pondahai/VFD_IV_18/README.md

# VFD_IV_18

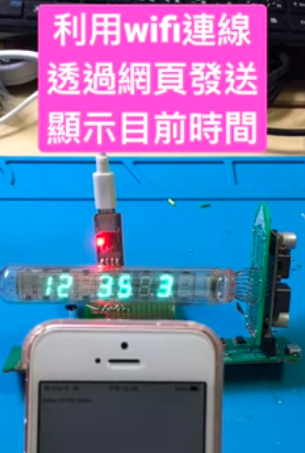
[picture p1: 截圖 2022-12-05 下午3.30.26.png]

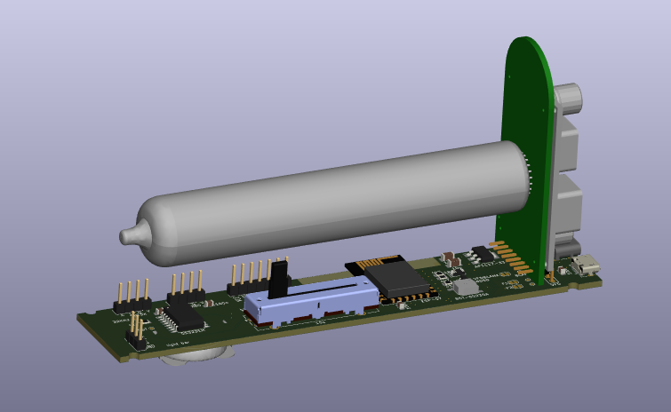
[picture p2: 截圖 2022-07-25 上午10.29.32.png]
