pondahai/VFD_IV_18/hardware/display/v1/IV-18/IV-18.stl

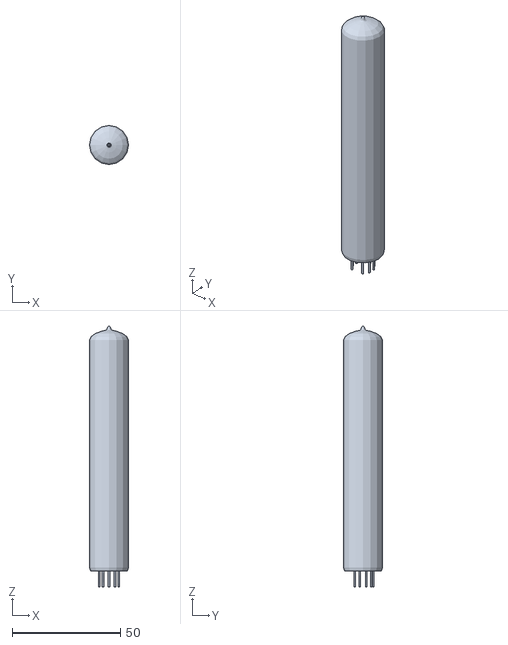
[picture p3: CAD file, 2022-07-25]
hardware/display/v1/IV-18/IV-18.stl
18.0 x 18.0 x 120.4
