pondahai/VFD_IV_18/hardware/main_board/v1/HRO  TYPE-C-31-M-12.step

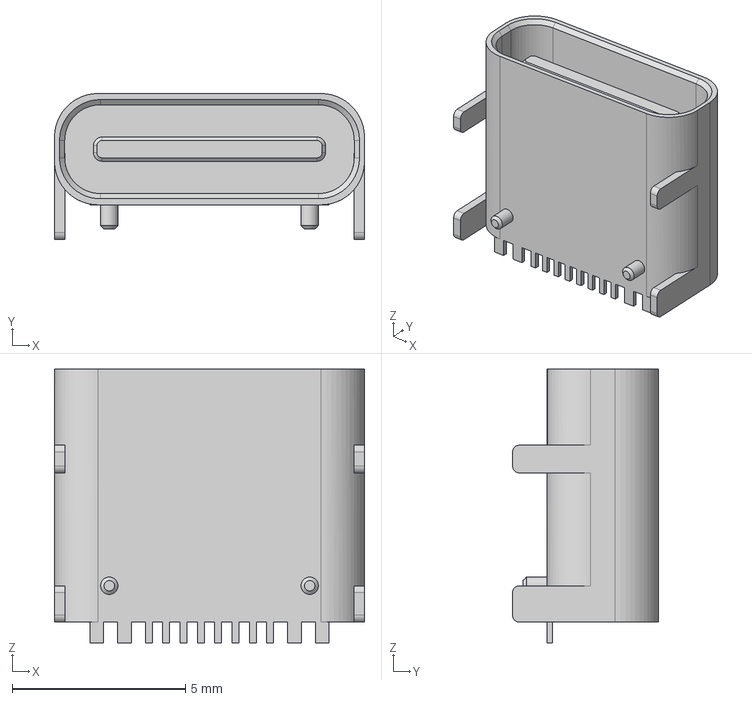
[picture p4: CAD file, 2022-12-05]
hardware/main_board/v1/HRO TYPE-C-31-M-12.step
8.94 x 4.21 x 7.90 mm
