pondahai/VFD_IV_18/hardware/main_board/v1/Battery Holder TH CR2032.stp

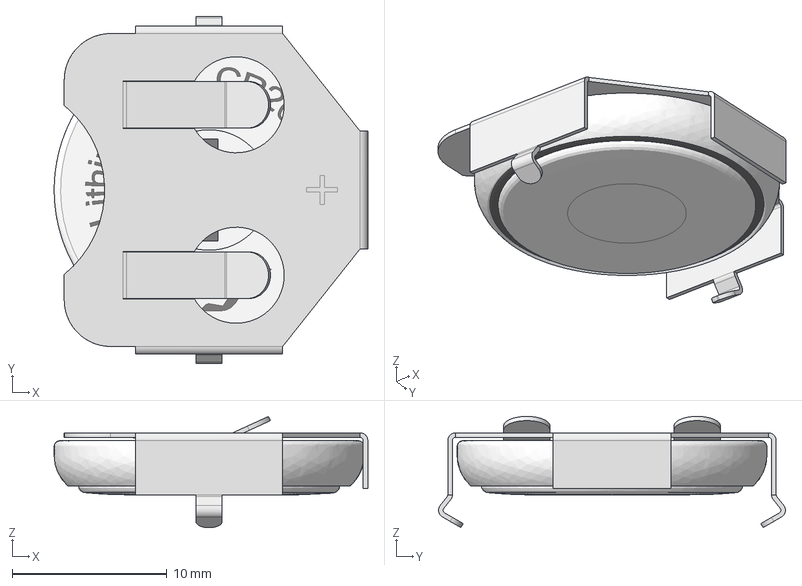
[picture p5: CAD file, 2022-12-05]
hardware/main_board/v1/Battery Holder TH CR2032.stp
20.2 x 22.4 x 7.18 mm
