pondahai/VFD_IV_18/hardware/main_board/v1/BST-5523SA.step

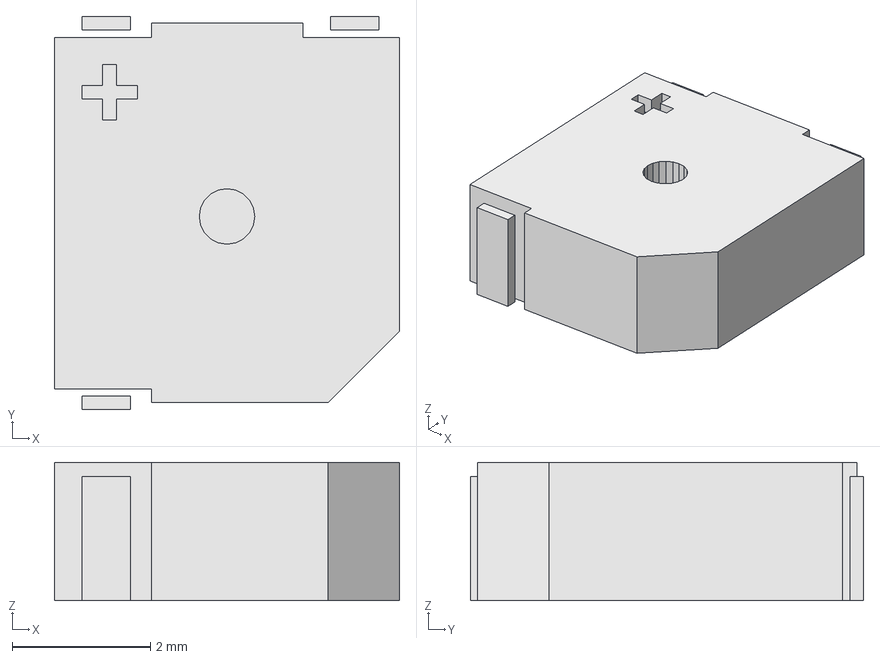
[picture p6: CAD file, 2022-07-25]
hardware/main_board/v1/BST-5523SA.step
5.00 x 5.70 x 2.00 mm
