pondahai/VFD_IV_18/hardware/main_board/v1/PTA2043-2010CIB103--3DModel-STEP-269445.step

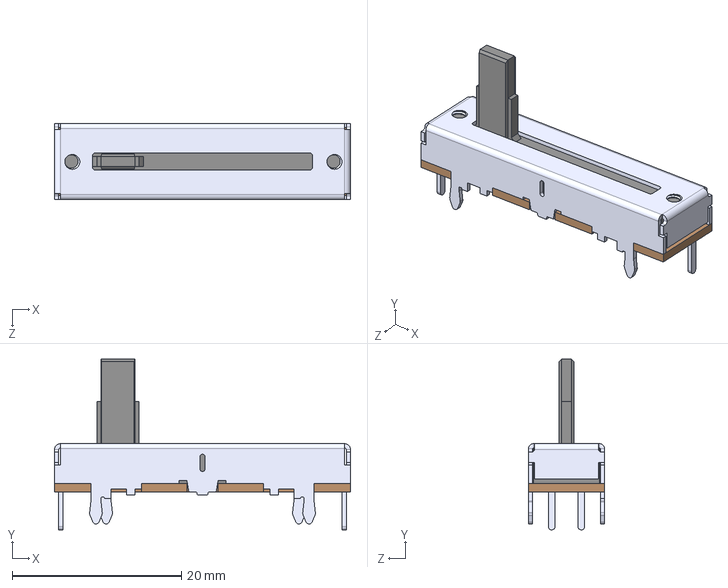
[picture p7: CAD file, 2022-07-25]
hardware/main_board/v1/PTA2043-2010CIB103--3DModel-STEP-269445.step
35.0 x 20.2 x 9.00 mm
