pondahai/VFD_IV_18/(list of files, cad)

Other CAD files:
hardware/main_board/v1/BST-5523SA.stl
