pondahai/VFD_IV_18/hardware/main_board/v1/main.kicad_pcb

## KiCad design hardware/main_board/v1/main.kicad_pcb (2022-12-05)

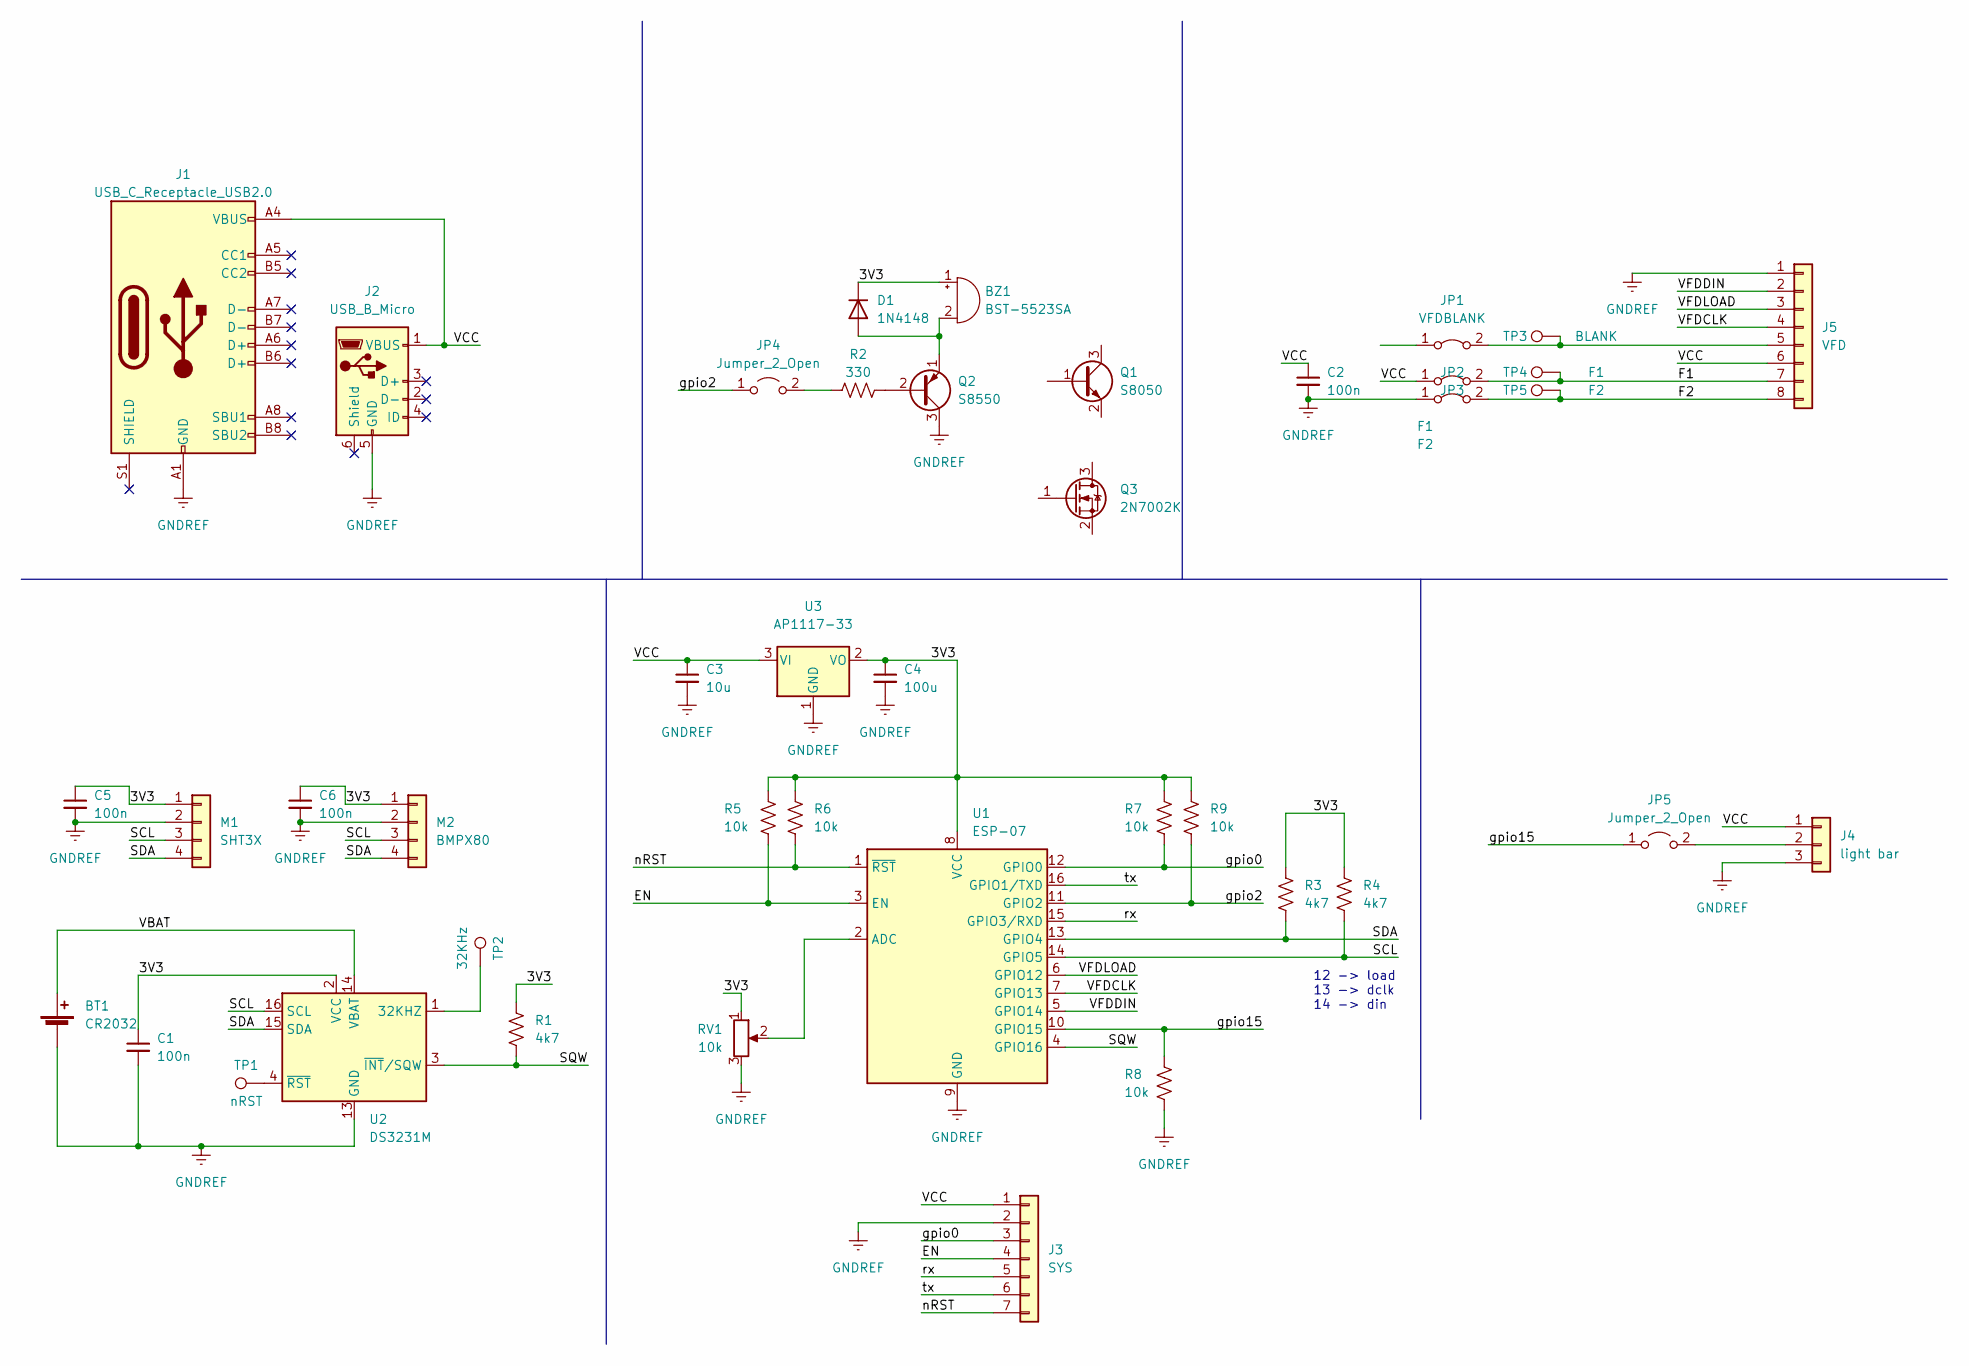
[picture p8: schematic main.kicad_sch]

Parts:
BT1: CR2032; BatteryHolder_Keystone_3002_1x2032
BZ1: BST-5523SA
C1, C2, C5, C6: 100n; C_0805_2012Metric_Pad1.18x1.45mm_HandSolder
C3: 10u; C_1206_3216Metric_Pad1.33x1.80mm_HandSolder
C4: 100u; C_1206_3216Metric_Pad1.33x1.80mm_HandSolder
D1: 1N4148; D_1206_3216Metric_Pad1.42x1.75mm_HandSolder
J1: USB_C_Receptacle_USB2.0; USB_C_Receptacle_Palconn_UTC16-G
J2: USB_B_Micro; USB_Micro-B_GCT_USB3076-30-A
J3: SYS; PinHeader_1x07_P2.54mm_Vertical
J4: light bar; PinHeader_1x03_P2.54mm_Vertical
J5: VFD; PinHeader_1x08_P2.54mm_Vertical
JP1: VFDBLANK; SolderJumper-2_P1.3mm_Bridged_RoundedPad1.0x1.5mm
JP2: F1; SolderJumper-2_P1.3mm_Bridged_RoundedPad1.0x1.5mm
JP3: F2; SolderJumper-2_P1.3mm_Bridged_RoundedPad1.0x1.5mm
JP4, JP5: Jumper_2_Open; SolderJumper-2_P1.3mm_Bridged_RoundedPad1.0x1.5mm
M1: SHT3X; PinHeader_1x04_P2.54mm_Vertical
M2: BMPX80; PinHeader_1x04_P2.54mm_Vertical
Q1: S8050; SOT-23
Q2: S8550; TO-92_Inline
Q3: 2N7002K; SOT-23
R1, R3, R4: 4k7; R_0805_2012Metric_Pad1.20x1.40mm_HandSolder
R2: 330; R_0805_2012Metric_Pad1.20x1.40mm_HandSolder
R5, R6, R7, R8, R9: 10k; R_0805_2012Metric_Pad1.20x1.40mm_HandSolder
RV1: 10k; Potentiometer_Bourns_PTA2043_Single_Slide
TP1: nRST; TestPoint_Pad_D1.0mm
TP2: 32KHz; TestPoint_Pad_D1.0mm
TP3: BLANK; TestPoint_Pad_D1.0mm
TP4: F1; TestPoint_Pad_D1.0mm
TP5: F2; TestPoint_Pad_D1.0mm
U1: ESP-07
U2: DS3231M; SOIC-16W_7.5x10.3mm_P1.27mm
U3: AP1117-33; SOT-223-3_TabPin2

Connections:
/3V3: BZ1.1 (-), C1.1, C4.1, C5.1, C6.1, D1.1 (K), M1.1, M2.1, R1.1, R3.1, R4.1, R5.1, R6.1, R7.1, R9.1, RV1.1, U1.8 (VCC), U2.2 (VCC), U3.2 (VO)
/EN: J3.4, R5.2, U1.3 (EN)
/F1: J5.7, JP2.2 (B), TP4.1
/F2: J5.8, JP3.2 (B), TP5.1
/SCL: M1.3, M2.3, R4.2, U1.14 (GPIO5), U2.16 (SCL)
/SDA: M1.4, M2.4, R3.2, U1.13 (GPIO4), U2.15 (SDA)
/SQW: R1.2, U1.4 (GPIO16), U2.3 (~INT/SQW)
/VBAT: BT1.1 (+), U2.14 (VBAT)
/VCC: C2.1, C3.1, J1.A4 (VBUS), J1.A9 (VBUS), J1.B4 (VBUS), J1.B9 (VBUS), J2.1 (VBUS), J3.1, J4.1, J5.6, JP2.1 (A), U3.3 (VI)
/VFDCLK: J5.4, U1.7 (GPIO13)
/VFDDIN: J5.2, U1.5 (GPIO14)
/VFDLOAD: J5.3, U1.6 (GPIO12)
/gpio0: J3.3, R7.2, U1.12 (GPIO0)
/gpio2: JP4.1 (A), R9.2, U1.11 (GPIO2)
/gpio15: JP5.1 (A), R8.1, U1.10 (GPIO15)
/nRST: J3.7, R6.2, U1.1 (~RST)
/rx: J3.5, U1.15 (GPIO3/RXD)
/tx: J3.6, U1.16 (GPIO1/TXD)
GNDREF: BT1.2 (-), C1.2, C2.2, C3.2, C4.2, C5.2, C6.2, J1.A1 (GND), J1.A12 (GND), J1.B1 (GND), J1.B12 (GND), J2.5 (GND), J3.2, J4.3, J5.1, JP3.1 (A), M1.2, M2.2, Q2.3 (C), R8.2, RV1.3, U1.9 (GND), U2.5 (GND), U2.6 (GND), U2.7 (GND), U2.8 (GND), U2.9 (GND), U2.10 (GND), U2.11 (GND), U2.12 (GND), U2.13 (GND), U3.1 (GND)
unnamed: BZ1.2 (+), BZ1.3, D1.2 (A), Q2.1 (E)
unnamed: J4.2, JP5.2 (B)
unnamed: J5.5, JP1.2 (B), TP3.1
unnamed: JP4.2 (B), R2.1
unnamed: Q2.2 (B), R2.2
unnamed: RV1.2, U1.2 (ADC)
unnamed: TP1.1, U2.4 (~RST)
unnamed: TP2.1, U2.1 (32KHZ)

Notes on the sheet:
12 -> load 13 -> dclk 14 -> din

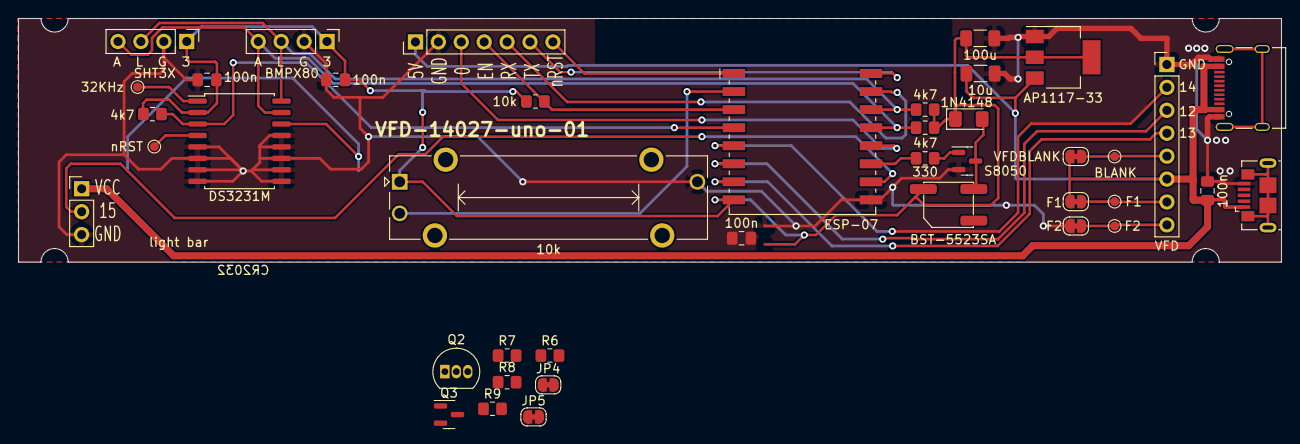
[picture p9: board main.kicad_pcb from above]

Board: 2 copper layers, 140.0 x 27.0 mm, 42 parts (1 on the bottom side), 27 nets.
