pondahai/VFD_IV_18/hardware/display/v1/VFD.kicad_pcb

## KiCad design hardware/display/v1/VFD.kicad_pcb (2022-07-25)

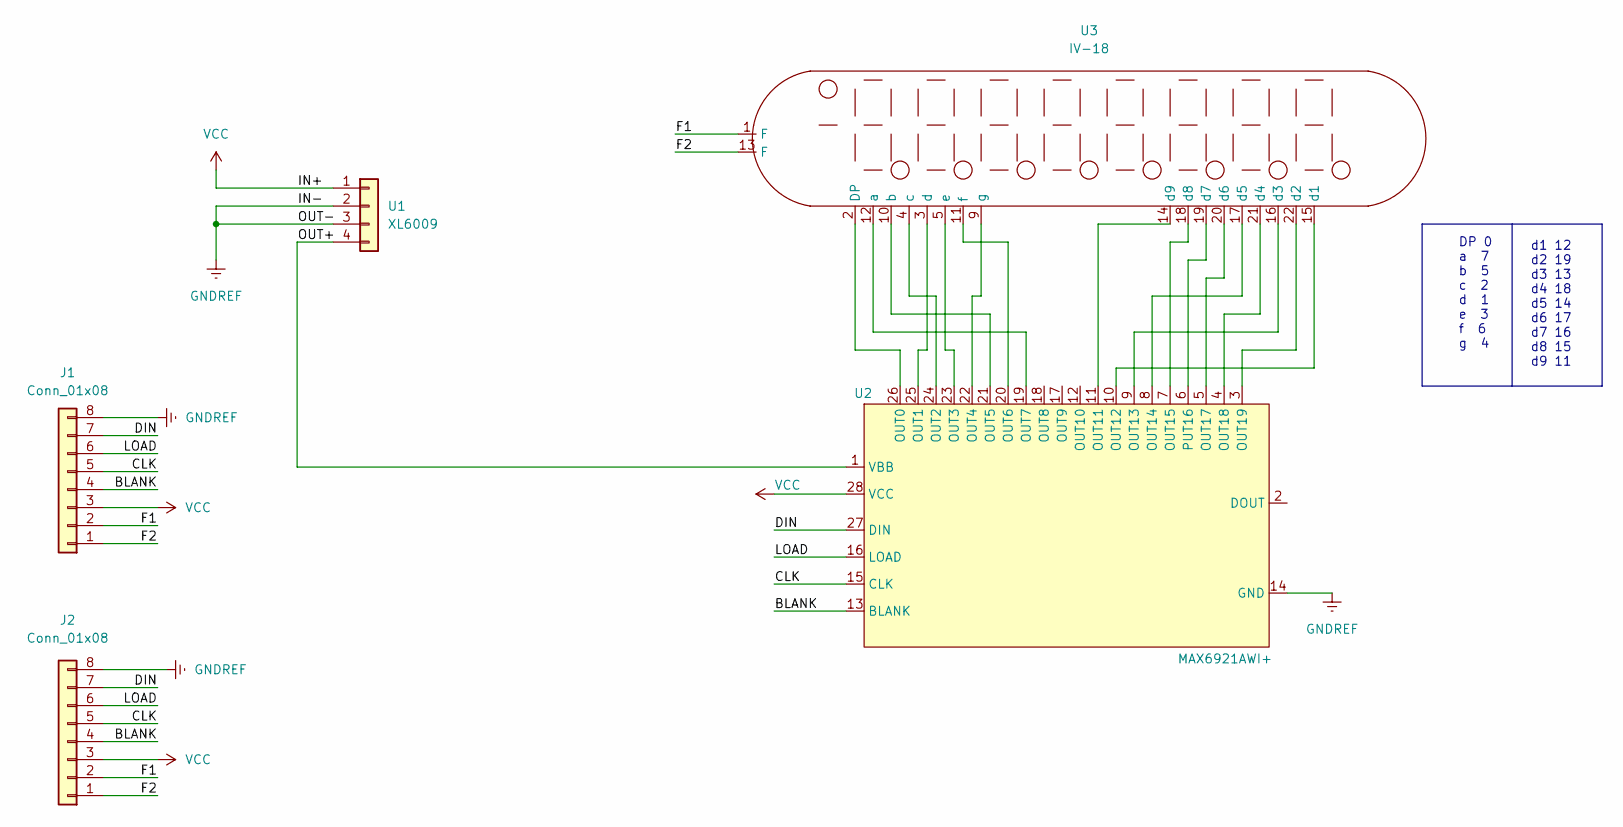
[picture p10: schematic VFD.kicad_sch]

Parts:
J1, J2: Conn_01x08; PinHeader_1x08_P2.54mm_Horizontal
U1: XL6009
U2: MAX6921AWI+; SOIC-28W_7.5x18.7mm_P1.27mm
U3: IV-18; IV-18_BOTTOM_VIEW

Connections:
/BLANK: J1.4, J2.4, U2.13 (BLANK)
/CLK: J1.5, J2.5, U2.15 (CLK)
/DIN: J1.7, J2.7, U2.27 (DIN)
/F1: J1.2, J2.2, U3.1 (F)
/F2: J1.1, J2.1, U3.13 (F)
/LOAD: J1.6, J2.6, U2.16 (LOAD)
/OUT+: U1.4, U2.1 (VBB)
GNDREF: J1.8, J2.8, U1.2, U1.3, U2.14 (GND)
unnamed: U2.3 (OUT19), U3.22 (d2)
unnamed: U2.4 (OUT18), U3.21 (d4)
unnamed: U2.5 (OUT17), U3.20 (d6)
unnamed: U2.6 (PUT16), U3.19 (d7)
unnamed: U2.7 (OUT15), U3.18 (d8)
unnamed: U2.8 (OUT14), U3.17 (d5)
unnamed: U2.9 (OUT13), U3.16 (d3)
unnamed: U2.10 (OUT12), U3.15 (d1)
unnamed: U2.11 (OUT11), U3.14 (d9)
unnamed: U2.19 (OUT7), U3.12 (a)
unnamed: U2.20 (OUT6), U3.11 (f)
unnamed: U2.21 (OUT5), U3.10 (b)
unnamed: U2.22 (OUT4), U3.9 (g)
unnamed: U2.23 (OUT3), U3.5 (e)
unnamed: U2.24 (OUT2), U3.4 (c)
unnamed: U2.25 (OUT1), U3.3 (d)
unnamed: U2.26 (OUT0), U3.2 (DP)
VCC: J1.3, J2.3, U1.1, U2.28 (VCC)

Notes on the sheet:
d1 12 d2 19 d3 13 d4 18 d5 14 d6 17 d7 16 d8 15 d9 11
DP 0 a 7 b 5 c 2 d 1 e 3 f 6 g 4

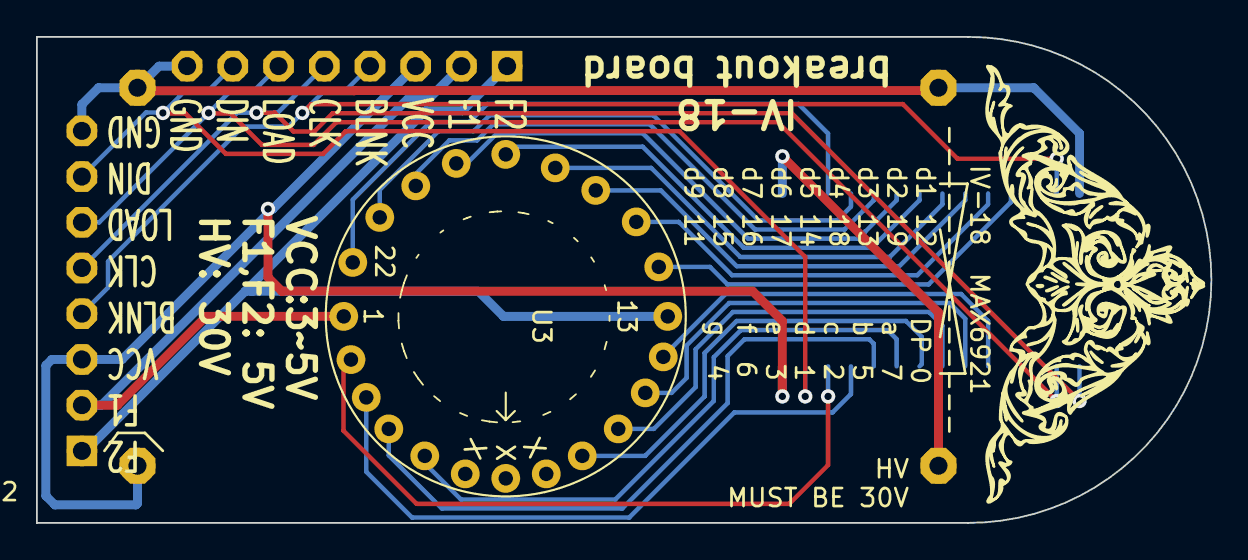
[picture p11: board VFD.kicad_pcb from above]

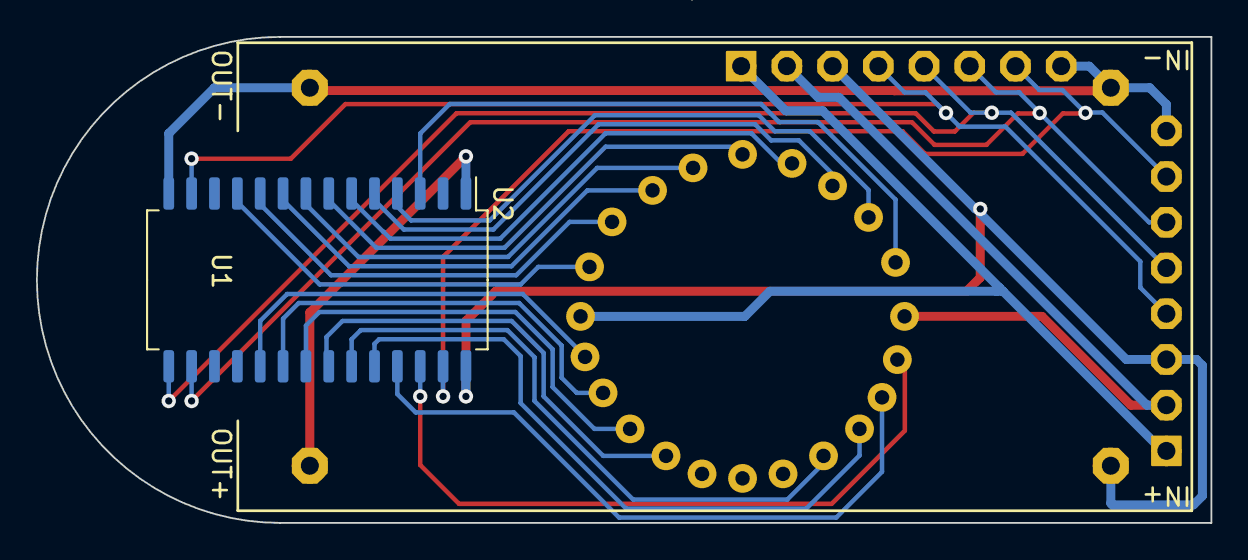
[picture p12: board VFD.kicad_pcb from below]

Board: 2 copper layers, 65.2 x 27.0 mm, 5 parts (3 on the bottom side), 26 nets.
